Irfaan-B/Macropad/Macropad_STM32/Hardware/Macropad_STM32.kicad_pcb

## KiCad design Macropad_STM32/Hardware/Macropad_STM32.kicad_pcb (2024-08-16)

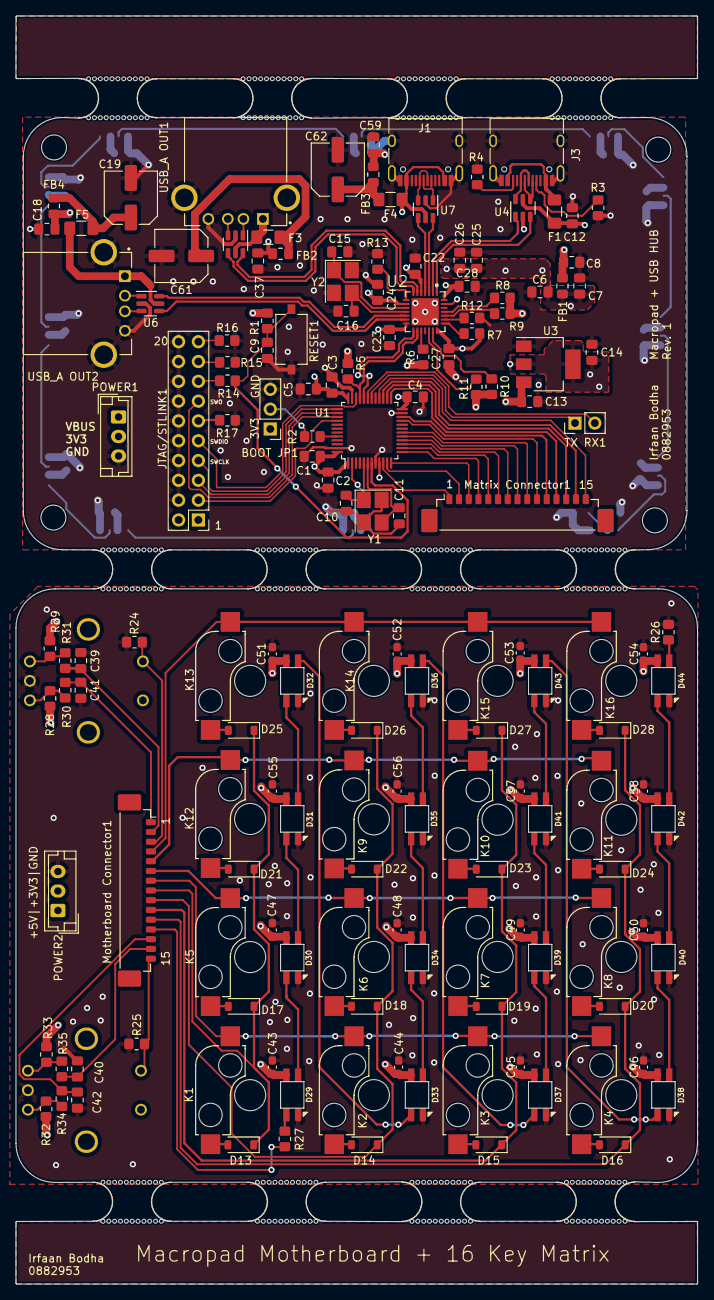
[picture p1: board Macropad_STM32.kicad_pcb from above]

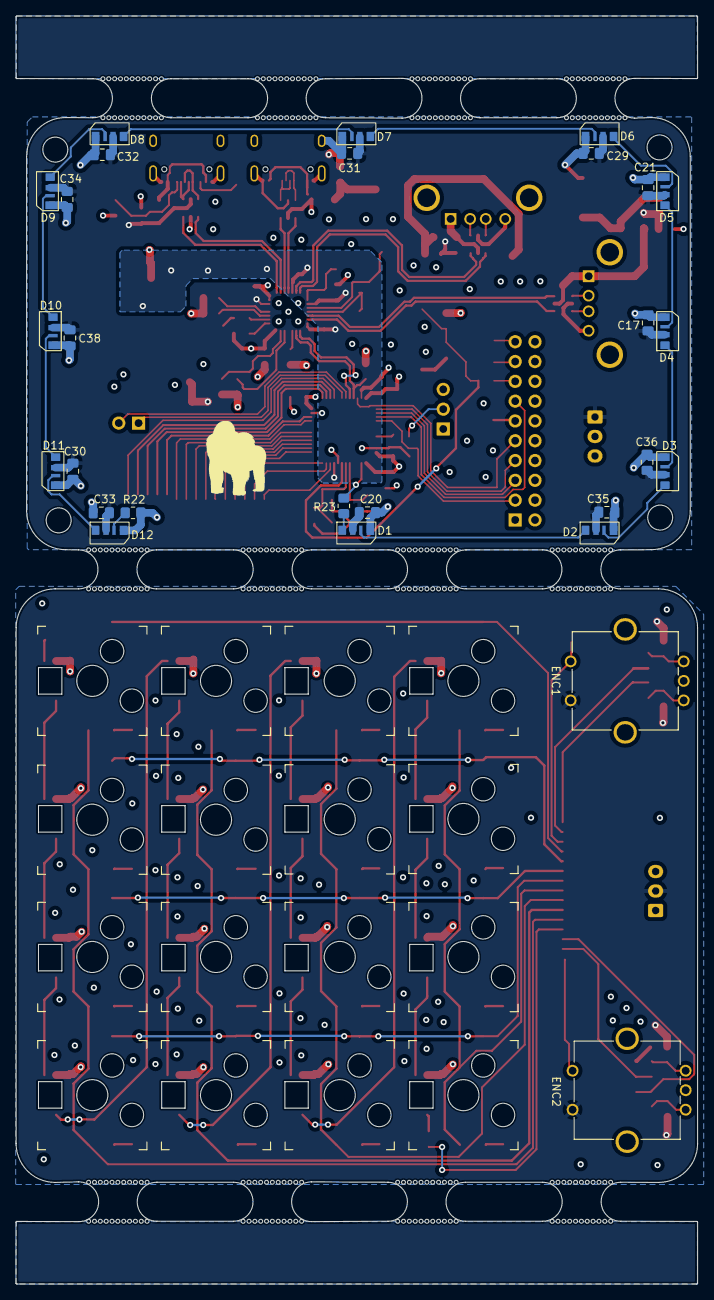
[picture p2: board Macropad_STM32.kicad_pcb from below]

Board: 4 copper layers, 87.4 x 162.6 mm, 199 parts (44 on the bottom side), 141 nets.

Parts:
BOOT JP1: Prog Jumper; PinHeader_1x03_P2.54mm_Vertical
C1, C2, C3, C4, C9, C17, C20, C21, C22, C23, C27, C29, C30, C31, C32, C33, C34, C35, C36, C38, C39, C40, C41, C42: 100n; C_0805_2012Metric_Pad1.18x1.45mm_HandSolder
C5, C12, C26: 10u; C_0805_2012Metric_Pad1.18x1.45mm_HandSolder
C6: 10n; C_0805_2012Metric_Pad1.18x1.45mm_HandSolder
C7, C8, C25, C28: 1u; C_0805_2012Metric_Pad1.18x1.45mm_HandSolder
C10, C11, C15, C16: 10p; C_0805_2012Metric_Pad1.18x1.45mm_HandSolder
C13, C14: 22u; C_0805_2012Metric_Pad1.18x1.45mm_HandSolder
C18, C37, C59: 2u2; C_0805_2012Metric_Pad1.18x1.45mm_HandSolder
C19, C61, C62: 100u; C_Elec_6.3x5.4
C24: locked; C_0805_2012Metric_Pad1.18x1.45mm_HandSolder
C43, C44, C45, C46, C47, C48, C49, C50, C51, C52, C53, C54, C55, C56, C57, C58: 100n; C_0603_1608Metric_Pad1.08x0.95mm_HandSolder
D1, D2, D3, D4, D5, D6, D7, D8, D9, D10, D11, D12: SK6812; SK6812SIDE
D13, D14, D15, D16, D17, D18, D19, D20, D21, D22, D23, D24, D25, D26, D27, D28: 1N4148; D_SOD-123
D29, D30, D31, D32, D33, D34, D35, D36, D37, D38, D39, D40, D41, D42, D43, D44: SK6812MINI; SK6812-MINI-E
ENC1, ENC2: EC11 Encoder; RotaryEncoder_Bourns_Vertical_PEC12R-3xxxF-Sxxxx
F1: 1A; Fuse_1206_3216Metric_Pad1.42x1.75mm_HandSolder
F3, F4, F5: 500mA; Fuse_1206_3216Metric_Pad1.42x1.75mm_HandSolder
FB1, FB2, FB3, FB4: 120R; Fuse_0805_2012Metric_Pad1.15x1.40mm_HandSolder
H1, H3, H4, H6: MountingHole; MountingHole_3.2mm_M3_DIN965
J1, J3: USB_C_Receptacle_USB2.0; USB_C_Receptacle_HRO_TYPE-C-31-M-12
J2, J8: USB_A; AMPHENOL_UE27AC54100
JTAG/STLINK1: JTAG; PinHeader_2x10_P2.54mm_Vertical
K1, K2, K3, K4, K5, K6, K7, K8, K9, K10, K11, K12, K13, K14, K15, K16: Kailh Hotswap Socket; Kailh_socket_MX_platemount
Matrix Connector1: 533981571; Molex_PicoBlade_53398-1571_1x15-1MP_P1.25mm_Vertical
Motherboard Connector1: 533981571; Molex_PicoBlade_53398-1571_1x15-1MP_P1.25mm_Vertical
POWER1, POWER2: Power Connector; JST_EH_B3B-EH-A_1x03_P2.50mm_Vertical
R1, R2, R6, R7, R8, R9, R10, R11, R12, R15, R16, R17: 10k; R_0805_2012Metric_Pad1.20x1.40mm_HandSolder
R3, R4: 5k1; R_0805_2012Metric_Pad1.20x1.40mm_HandSolder
R5: 1k5; R_0805_2012Metric_Pad1.20x1.40mm_HandSolder
R13: 649; R_0805_2012Metric_Pad1.20x1.40mm_HandSolder
R14: 0; R_0805_2012Metric_Pad1.20x1.40mm_HandSolder
R22, R23, R26, R27: 500; R_0805_2012Metric_Pad1.20x1.40mm_HandSolder
R24, R25, R28, R29, R30, R31, R32, R33, R34, R35: 10K; R_0805_2012Metric_Pad1.20x1.40mm_HandSolder
RESET1: SW_Push; SW_Tactile_SPST_NO_Straight_CK_PTS636Sx25SMTRLFS
TX RX1: Conn_01x02_Socket; PinHeader_1x02_P2.54mm_Vertical
U1: STM32F103C8T6; LQFP-48_7x7mm_P0.5mm
U2: CY7C65632-28LTXCT; QFN50P500X500X80-29N
U3: AMS1117-3.3; SOT-223-3_TabPin2
U4, U6, U7, U8: USBLC6-2SC6; SOT-23-6
Y1: 16MHz; Crystal_SMD_3225-4Pin_3.2x2.5mm_HandSoldering
Y2: 12MHz; Crystal_SMD_3225-4Pin_3.2x2.5mm_HandSoldering
mouse-bite-5mm-slot, mouse-bite-5mm-slot#2, mouse-bite-5mm-slot#3, mouse-bite-5mm-slot#4, mouse-bite-5mm-slot#5, mouse-bite-5mm-slot#6, mouse-bite-5mm-slot#7, mouse-bite-5mm-slot#8, mouse-bite-5mm-slot#9, mouse-bite-5mm-slot#10, mouse-bite-5mm-slot#11, mouse-bite-5mm-slot#12: VAL**; mouse-bite-5mm-slot

Connections:
+3.3V: BOOT JP1.1 (A), C1.1, C2.1, C3.1, C4.1, C5.1, C8.1, C14.1, C27.1, C28.1, FB1.2, JTAG/STLINK1.1 (VTREF), JTAG/STLINK1.2 (VCC/NC), POWER1.2, R1.1, R5.2, R6.1, R7.1, R8.1, R9.1, R10.1, R11.1, U1.1 (VBAT), U1.24 (VDD), U1.36 (VDD), U1.48 (VDD), U2.21 (VCC_D), U2.28 (VREG), U3.2 (VO)
+3.3VA: C6.1, C7.1, C22.1, C23.1, C24.1, C25.1, C26.1, FB1.1, U1.9 (VDDA), U2.5 (VCC_A), U2.9 (VCC_A), U2.14 (VCC_A)
+3V3: ENC1.S1, ENC2.S1, POWER2.2, R28.2, R29.1, R32.1, R33.1
+5V: C43.1, C44.1, C45.1, C46.1, C47.1, C48.1, C49.1, C50.1, C51.1, C52.1, C53.1, C54.1, C55.1, C56.1, C57.1, C58.1, D29.1 (VDD), D30.1 (VDD), D31.1 (VDD), D32.1 (VDD), D33.1 (VDD), D34.1 (VDD), D35.1 (VDD), D36.1 (VDD), D37.1 (VDD), D38.1 (VDD), D39.1 (VDD), D40.1 (VDD), D41.1 (VDD), D42.1 (VDD), D43.1 (VDD), D44.1 (VDD), POWER2.1
/BOOT0: R2.2, U1.44 (BOOT0)
/COL0: Matrix Connector1.7, U1.16 (PA6)
/COL1: Matrix Connector1.6, U1.15 (PA5)
/COL2: Matrix Connector1.5, U1.14 (PA4)
/COL3: Matrix Connector1.4, U1.13 (PA3)
/ENC1_A: Matrix Connector1.1, U1.10 (PA0)
/ENC1_B: Matrix Connector1.2, U1.11 (PA1)
/ENC1_SW: Matrix Connector1.3, U1.12 (PA2)
/ENC2_A: Matrix Connector1.13, U1.26 (PB13)
/ENC2_B: Matrix Connector1.14, U1.27 (PB14)
/ENC2_SW: Matrix Connector1.15, U1.28 (PB15)
/HSE_IN: C10.1, U1.5 (PD0), Y1.1
/HSE_OUT: C11.1, U1.6 (PD1), Y1.3
/JP_BOOT0: BOOT JP1.2 (C), R2.1
/Key_LED: Matrix Connector1.12, U1.25 (PB12)
/LED: R23.1, U1.2 (PC13)
/LED0: D4.3 (DOUT), D5.1 (DIN)
/LED1: D8.3 (DOUT), D9.1 (DIN)
/Matrix/COL0: K1.1, K2.1, K3.1, K4.1, Motherboard Connector1.7
/Matrix/COL1: K5.1, K6.1, K7.1, K8.1, Motherboard Connector1.6
/Matrix/COL2: K9.1, K10.1, K11.1, K12.1, Motherboard Connector1.5
/Matrix/COL3: K13.1, K14.1, K15.1, K16.1, Motherboard Connector1.4
/Matrix/ENC_1_A: C41.1, Motherboard Connector1.1, R30.2
/Matrix/ENC_1_B: C39.1, Motherboard Connector1.2, R31.2
/Matrix/ENC_1_SW: ENC1.S2, Motherboard Connector1.3, R24.2
/Matrix/ENC_2_A: C42.1, Motherboard Connector1.13, R34.2
/Matrix/ENC_2_B: C40.1, Motherboard Connector1.14, R35.2
/Matrix/ENC_2_SW: ENC2.S2, Motherboard Connector1.15, R25.2
/Matrix/Key_LED: Motherboard Connector1.12, R27.1
/Matrix/LED45: D32.2 (DOUT), D33.4 (DIN)
/Matrix/LED89: D36.2 (DOUT), D37.4 (DIN)
/Matrix/LED1213: D38.4 (DIN), D43.2 (DOUT)
/Matrix/ROW0: D13.1 (K), D17.1 (K), D21.1 (K), D25.1 (K), Motherboard Connector1.8
/Matrix/ROW1: D14.1 (K), D18.1 (K), D22.1 (K), D26.1 (K), Motherboard Connector1.9
/Matrix/ROW2: D15.1 (K), D19.1 (K), D23.1 (K), D27.1 (K), Motherboard Connector1.10
/Matrix/ROW3: D16.1 (K), D20.1 (K), D24.1 (K), D28.1 (K), Motherboard Connector1.11
/NRST: C9.1, R1.2, R14.2, RESET1.1, U1.7 (NRST)
/ROW0: Matrix Connector1.8, U1.17 (PA7)
/ROW1: Matrix Connector1.9, U1.18 (PB0)
/ROW2: Matrix Connector1.10, U1.21 (PB10)
/ROW3: Matrix Connector1.11, U1.22 (PB11)
/SWCLK: JTAG/STLINK1.7 (TMS/SWDIO), U1.37 (PA14)
/SWDIO: JTAG/STLINK1.9 (TCK/SWDCLK), U1.34 (PA13)
/SWO: JTAG/STLINK1.13 (TDO/SWO), U1.39 (PB3)
/TDI: JTAG/STLINK1.5 (TDI), U1.38 (PA15)
/UP_USB_D+: U2.2 (D+), U4.1 (IO1)
/UP_USB_D-: U2.1 (D–), U4.3 (IO2)
/USBHUB/D1_D+: U2.4 (DD+1), U7.4 (IO2)
/USBHUB/D1_D-: U2.3 (DD–1), U7.6 (IO1)
/USBHUB/D1_VBUS: F3.1, J2.1 (VBUS), U8.5 (VBUS)
/USBHUB/D2_D+: U2.7 (DD+2), U8.4 (IO2)
/USBHUB/D2_D-: U2.6 (DD–2), U8.6 (IO1)
/USBHUB/D2_VBUS: F5.1, J8.1 (VBUS), U6.5 (VBUS)
/USBHUB/D3_D+: U2.13 (DD+3), U6.4 (IO2)
/USBHUB/D3_D-: U2.12 (DD–3), U6.6 (IO1)
/USBHUB/D3_VBUS: F4.1, J1.A4 (VBUS), J1.A9 (VBUS), J1.B4 (VBUS), J1.B9 (VBUS), U7.5 (VBUS)
/USBHUB/USB_SELFPWR: R7.2, U2.22 (SELFPWR)
/USBHUB/USB_XIN: C15.1, U2.10 (XIN), Y2.1
/USBHUB/USB_XOUT: C16.1, U2.11 (XOUT), Y2.3
/USBHUB/USB_nRST: R6.2, U2.17 (~RESET)
/USBHUB/nOVR1: R8.2, U2.25 (~OVR~1)
/USBHUB/nOVR2: R9.2, U2.24 (~OVR~2)
/USBHUB/nOVR3: R10.2, U2.20 (~OVR~3)
/USBHUB/nOVR4: R11.2, U2.19 (~OVR~4)
/USB_DN_D+: R5.1, U1.33 (PA12), U2.16 (DD+4)
/USB_DN_D-: U1.32 (PA11), U2.15 (DD–4)
/USB_UP_D+: J3.A6 (D+), J3.B6 (D+), U4.6 (IO1)
/USB_UP_D-: J3.A7 (D-), J3.B7 (D-), U4.4 (IO2)
/sRST: JTAG/STLINK1.15 (~SRST), R14.1
/tRST: JTAG/STLINK1.3 (~TRST), U1.40 (PB4)
GND: BOOT JP1.3 (B), C1.2, C2.2, C3.2, C4.2, C5.2, C6.2, C7.2, C8.2, C9.2, C10.2, C11.2, C12.1, C13.2, C14.2, C15.2, C16.2, C17.2, C18.2, C19.2, C20.2, C21.2, C22.2, C23.2, C24.2, C25.2, C26.2, C27.2, C28.2, C29.2, C30.2, C31.2, C32.2, C33.2, C34.2, C35.2, C36.2, C37.2, C38.2, C59.2, C61.2, C62.2, D1.4 (VSS), D2.4 (VSS), D3.4 (VSS), D4.4 (VSS), D5.4 (VSS), D6.4 (VSS), D7.4 (VSS), D8.4 (VSS), D9.4 (VSS), D10.4 (VSS), D11.4 (VSS), D12.4 (VSS), J1.A1 (GND), J1.A12 (GND), J1.B1 (GND), J1.B12 (GND), J1.S1 (SHIELD), J2.4 (GND), J2.5 (Shield), J3.A1 (GND), J3.A12 (GND), J3.B1 (GND), J3.B12 (GND), J3.S1 (SHIELD), J8.4 (GND), J8.5 (Shield), JTAG/STLINK1.4 (GND), JTAG/STLINK1.6 (GND), JTAG/STLINK1.8 (GND), JTAG/STLINK1.10 (GND), JTAG/STLINK1.12 (GND), JTAG/STLINK1.14 (GND), JTAG/STLINK1.16 (GND), JTAG/STLINK1.18 (GND), JTAG/STLINK1.20 (GND), POWER1.3, R3.2, R4.2, R12.1, R13.2, R15.2, R16.2, R17.2, R22.2, RESET1.2, U1.8 (VSSA), U1.23 (VSS), U1.35 (VSS), U1.47 (VSS), U2.29 (GND), U3.1 (GND), U4.2 (GND), U6.2 (GND), U7.2 (GND), U8.2 (GND), Y1.2, Y1.4, Y2.2, Y2.4
GND1: C39.2, C40.2, C41.2, C42.2, C43.2, C44.2, C45.2, C46.2, C47.2, C48.2, C49.2, C50.2, C51.2, C52.2, C53.2, C54.2, C55.2, C56.2, C57.2, C58.2, D29.3 (VSS), D30.3 (VSS), D31.3 (VSS), D32.3 (VSS), D33.3 (VSS), D34.3 (VSS), D35.3 (VSS), D36.3 (VSS), D37.3 (VSS), D38.3 (VSS), D39.3 (VSS), D40.3 (VSS), D41.3 (VSS), D42.3 (VSS), D43.3 (VSS), D44.3 (VSS), ENC1.C, ENC2.C, POWER2.3, R24.1, R25.1, R26.2
unnamed: C19.1, F5.2, FB4.1
unnamed: C61.1, F3.2, FB2.1
unnamed: C62.1, F4.2, FB3.1
unnamed: D1.1 (DIN), R23.2
unnamed: D1.3 (DOUT), D2.1 (DIN)
unnamed: D2.3 (DOUT), D3.1 (DIN)
unnamed: D3.3 (DOUT), D4.1 (DIN)
unnamed: D5.3 (DOUT), D6.1 (DIN)
unnamed: D6.3 (DOUT), D7.1 (DIN)
unnamed: D7.3 (DOUT), D8.1 (DIN)
unnamed: D9.3 (DOUT), D10.1 (DIN)
unnamed: D10.3 (DOUT), D11.1 (DIN)
unnamed: D11.3 (DOUT), D12.1 (DIN)
unnamed: D12.3 (DOUT), R22.1
unnamed: D13.2 (A), K1.2
unnamed: D14.2 (A), K2.2
unnamed: D15.2 (A), K3.2
unnamed: D16.2 (A), K4.2
unnamed: D17.2 (A), K5.2
unnamed: D18.2 (A), K6.2
unnamed: D19.2 (A), K7.2
unnamed: D20.2 (A), K8.2
unnamed: D21.2 (A), K12.2
unnamed: D22.2 (A), K9.2
unnamed: D23.2 (A), K10.2
unnamed: D24.2 (A), K11.2
unnamed: D25.2 (A), K13.2
unnamed: D26.2 (A), K14.2
unnamed: D27.2 (A), K15.2
unnamed: D28.2 (A), K16.2
unnamed: D29.4 (DIN), R27.2
unnamed: D29.2 (DOUT), D30.4 (DIN)
unnamed: D30.2 (DOUT), D31.4 (DIN)
unnamed: D31.2 (DOUT), D32.4 (DIN)
unnamed: D33.2 (DOUT), D34.4 (DIN)
unnamed: D34.2 (DOUT), D35.4 (DIN)
unnamed: D35.2 (DOUT), D36.4 (DIN)
unnamed: D37.2 (DOUT), D39.4 (DIN)
unnamed: D38.2 (DOUT), D40.4 (DIN)
unnamed: D39.2 (DOUT), D41.4 (DIN)
unnamed: D40.2 (DOUT), D42.4 (DIN)
unnamed: D41.2 (DOUT), D43.4 (DIN)
unnamed: D42.2 (DOUT), D44.4 (DIN)
unnamed: D44.2 (DOUT), R26.1
unnamed: ENC1.A, R28.1, R30.1
unnamed: ENC1.B, R29.2, R31.1
unnamed: ENC2.A, R32.2, R34.1
unnamed: ENC2.B, R33.2, R35.1
unnamed: F1.1, J3.A4 (VBUS), J3.A9 (VBUS), J3.B4 (VBUS), J3.B9 (VBUS)
unnamed: J1.A6 (D+), J1.B6 (D+), U7.3 (IO2)
unnamed: J1.A7 (D-), J1.B7 (D-), U7.1 (IO1)
unnamed: J2.3 (D+), U8.3 (IO2)
unnamed: J2.2 (D-), U8.1 (IO1)
unnamed: J3.A5 (CC1), R3.1
unnamed: J3.B5 (CC2), R4.1
unnamed: J8.3 (D+), U6.3 (IO2)
unnamed: J8.2 (D-), U6.1 (IO1)
unnamed: JTAG/STLINK1.19 (DBGACK/NC), R16.1
unnamed: JTAG/STLINK1.17 (DBGRQ/NC), R15.1
unnamed: JTAG/STLINK1.11 (RTCK), R17.1
unnamed: TX RX1.1, U1.30 (PA9)
unnamed: TX RX1.2, U1.31 (PA10)
unnamed: R12.2, U2.23 (GANG)
unnamed: R13.1, U2.8 (RREF)
VBUS: C12.2, C13.1, C17.1, C18.1, C20.1, C21.1, C29.1, C30.1, C31.1, C32.1, C33.1, C34.1, C35.1, C36.1, C37.1, C38.1, C59.1, D1.2 (VDD), D2.2 (VDD), D3.2 (VDD), D4.2 (VDD), D5.2 (VDD), D6.2 (VDD), D7.2 (VDD), D8.2 (VDD), D9.2 (VDD), D10.2 (VDD), D11.2 (VDD), D12.2 (VDD), F1.2, FB2.2, FB3.2, FB4.2, POWER1.1, U2.27 (VCC), U3.3 (VI), U4.5 (VBUS)
