Irfaan-B/Macropad/Macropad_STM32/Software/Core/Src/main.c

/* Includes ------------------------------------------------------------------*/
#include "main.h"
#include "usb_device.h"
#include "led.h"
#include "keypad.h"

/* USER CODE BEGIN PD */

// Define the timing constants (in clock cycles)
#define T0H  1  // 0.32 µs
#define T1H  3  // 0.64 µs
#define T0L  3   // 0.8 µs
#define T1L  1   // 0.2 µs
#define TRST 5000    // >80 µs

/* USER CODE END PD */


/* USER CODE BEGIN PV */
uint16_t led_data[NUM_LEDS][3]; // Assuming 24 bits per LED
/* USER CODE END PV */

void SystemClock_Config(void);
static void MX_GPIO_Init(void);
/* USER CODE BEGIN 0 */
void cycle_colors(void) {
    static uint8_t color_index = 0;
    uint8_t colors[3][3] = {
        {255, 0, 0},   // Red
        {0, 255, 0},   // Green
        {0, 0, 255}    // Blue
    };

    for (uint8_t i = 0; i < NUM_LEDS; i++) {
        set_led_color(i, colors[color_index][0], colors[color_index][1], colors[color_index][2]);
    }

    color_index = (color_index + 1) % 3;
}
/* USER CODE END 0 */

/**
  * @brief  The application entry point.
  * @retval int
  */
int main(void)
{
    /* USER CODE BEGIN 1 */
    __set_CONTROL(0);
    __ISB();

    /* USER CODE END 1 */

    /* MCU Configuration--------------------------------------------------------*/

    /* Reset of all peripherals, Initializes the Flash interface and the Systick. */
    HAL_Init();

    /* Configure the system clock */
    SystemClock_Config();

    /* Initialize all configured peripherals */
    MX_GPIO_Init();
    MX_USB_DEVICE_Init();
    /* USER CODE BEGIN 2 */
    for (uint8_t i = 0; i < NUM_LEDS; i++) 
    {
      set_led_color(i, 255, 0, 0); // Set all LEDs to red
    }

    char key;

    /* USER CODE END 2 */

    /* Infinite loop */
    /* USER CODE BEGIN WHILE */
    while (1)
    {
      key = Keypad_Scan();

      if (key != '\0')
      {
        Keypad_SendKeyViaUSB(key);
        HAL_Delay(150);
      }
      // __disable_irq();
      // cycle_colors(); // Cycle through colors
      // update_leds(); // Update all LEDs
      // __enable_irq();
      // HAL_Delay(1000);
    /* USER CODE END WHILE */
    }
}

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
