Irfaan-B/Macropad/(commit log)

2023-11-02 Working on USB Hub
    [Macropad_STM32.kicad_sch, USBHUB.kicad_sch]
2023-11-03 USB Hub & Jtag connectors added Todo: - Keypad matrix - Rotary encoders - PCB
    [Macropad_STM32.kicad_sch, USBHUB.kicad_sch]
2023-11-04 Finished main schematic (excl. matrix)
    [Macropad_STM32.kicad_pcb, Macropad_STM32.kicad_sch, USBHUB.kicad_sch]
2023-11-05 Matrix PCB layout done
    [Macropad_STM32.kicad_pcb, Macropad_STM32.kicad_sch, MatrixPCB.kicad_pcb, MatrixPCB.kicad_sch, MatrixPCB.step, MatrixPCB1.step, matrix.kicad_sch]
2023-11-05 Finished PCB layout, TODO: traces
    [Macropad_STM32.kicad_pcb, Macropad_STM32.kicad_sch, MatrixPCB.step, USBHUB.kicad_sch, matrix.kicad_sch]
2023-12-10 Schematic changes Motherboard nearing completion
    [Macropad_STM32.kicad_pcb, Macropad_STM32.kicad_sch, USBHUB.kicad_sch, matrix.kicad_sch]
2023-12-10 Minor changes to motherboard
    [Macropad_STM32.kicad_pcb]
2023-12-11 Revision 1 nearly finished
    [Macropad_STM32.kicad_pcb, Macropad_STM32.kicad_sch, USBHUB.kicad_sch, matrix.kicad_sch]
2023-12-28 Nearly finished Todo: - Fix silkscreen - Final check
    [Macropad_STM32.kicad_pcb, Macropad_STM32.kicad_sch, USBHUB.kicad_sch, matrix.kicad_sch]
2024-01-28 Hardware finished and motherboard has been tested. Todo: Test keyboard matrix and write firmware.
    [Macropad_STM32.kicad_sch, MatrixPCB.kicad_pcb, MatrixPCB1.step, USBHUB.kicad_sch, matrix.kicad_sch]
2024-08-16 Cleaned up repo, added software folder
    [Macropad_STM32.kicad_pcb, Macropad_STM32.kicad_sch, USBHUB.kicad_sch, matrix.kicad_sch]
2024-08-16 Clean up
    [Macropad_STM32.kicad_pcb, Macropad_STM32.kicad_sch, USBHUB.kicad_sch, matrix.kicad_sch]
2024-08-16 Can now program & flash the mcu without using stm32cubeide. yippee!
2024-08-16 LED software added
2024-08-17 Make working in vscode, leds not. Fix soon?
    [STM32Macropad.ioc, main.c, main.h]
